lazar2222/PHI-GPC/README.md

# Human-Machine Interface for Music Applications

This graduation thesis project aimed to create a customizable control surface resembling audio mixers and video switchers. Implemented using an Arduino microcontroller and C# desktop software, the system enables full customization of each control. For detailed information, refer to the [thesis](Tex/maturski.pdf) and [presentation](Tex/Odbrana.pdf).
