lazar2222/PHI-GPC/Tex/Odbrana.pdf

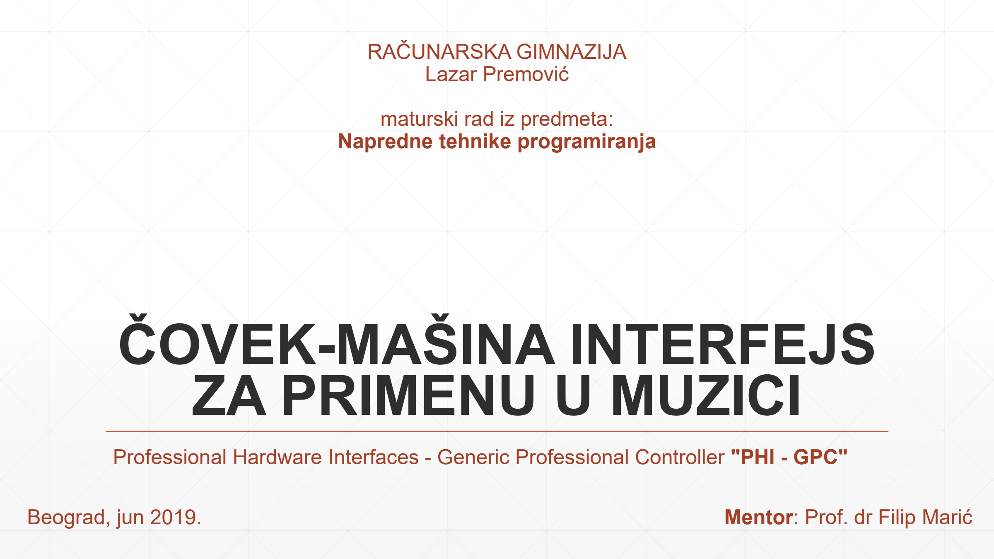
[picture p9: figure]
ČOVEK-MAŠINA INTERFEJS ZA PRIMENU U MUZICI; RAČUNARSKA GIMNAZIJA Lazar Premović; maturski rad iz predmeta: Napredne tehnike programiranja; Beograd, jun 2019.; Mentor: Prof. dr Filip Marić

Professional Hardware Interfaces - Generic Professional Controller "PHI - GPC"

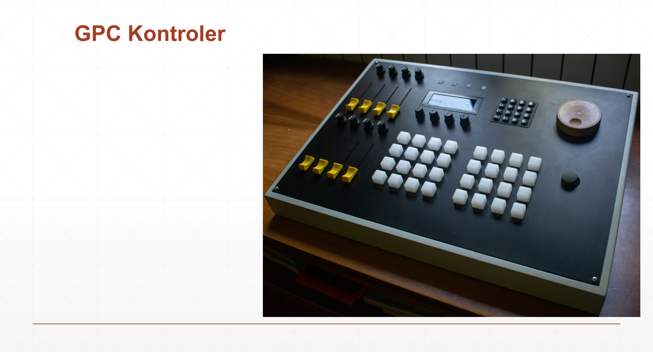
[picture p10: figure]
GPC Kontroler

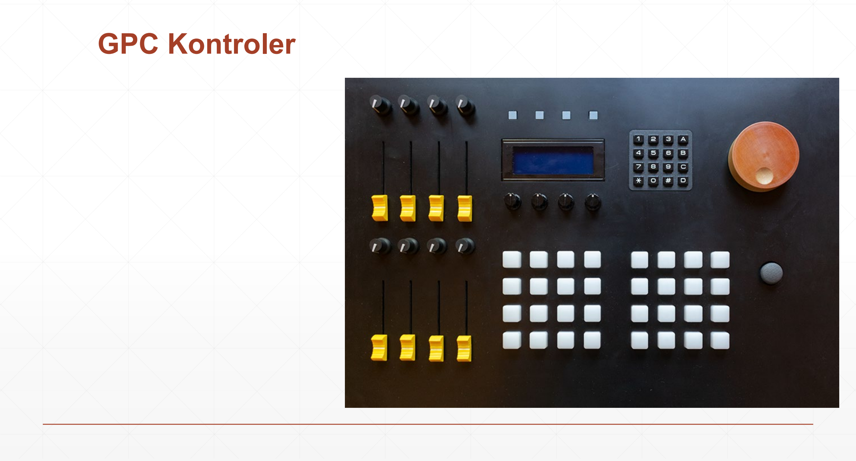
[picture p11: figure]
GPC Kontroler

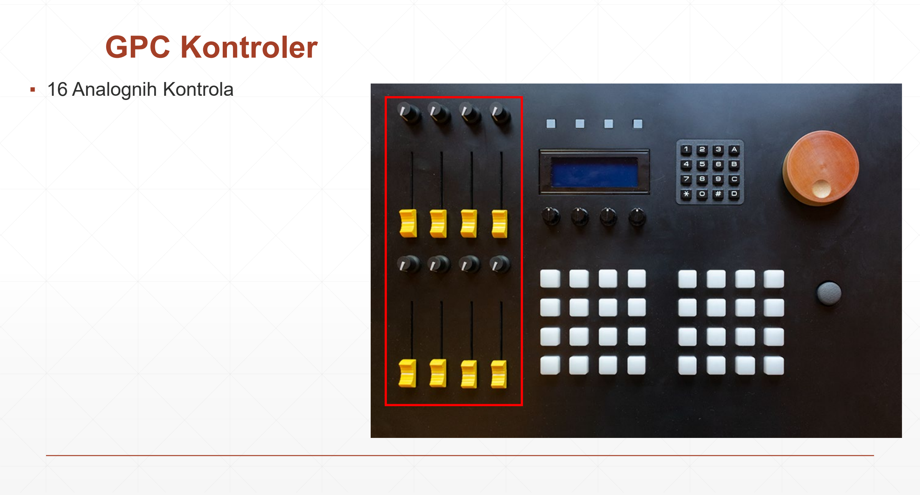
[picture p12: figure]
GPC Kontroler; ▪ 16 Analognih Kontrola

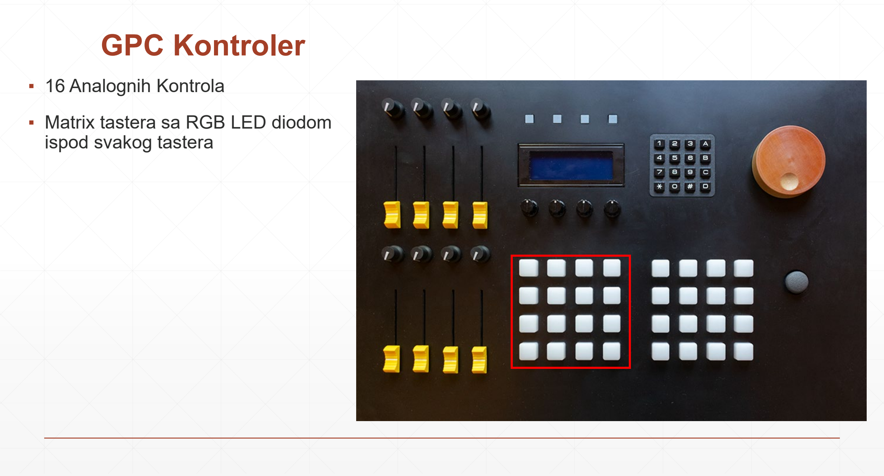
[picture p13: figure]
GPC Kontroler; ▪ 16 Analognih Kontrola ▪ Matrix tastera sa RGB LED diodom ispod svakog tastera

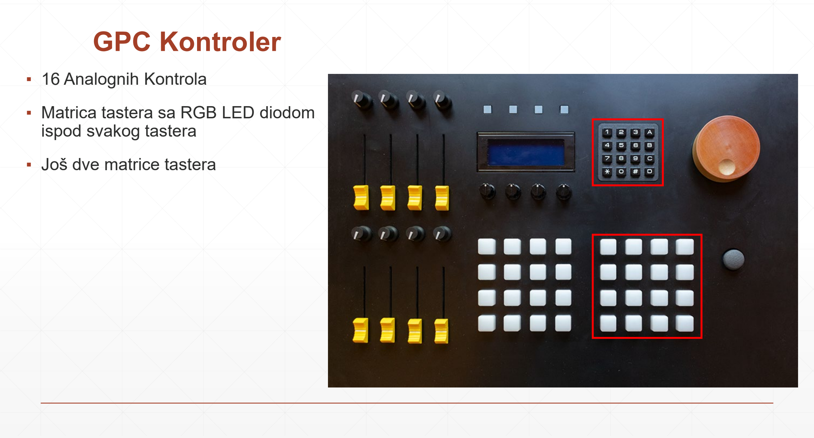
[picture p14: figure]
GPC Kontroler; ▪ 16 Analognih Kontrola ▪ Matrica tastera sa RGB LED diodom ispod svakog tastera ▪ Još dve matrice tastera

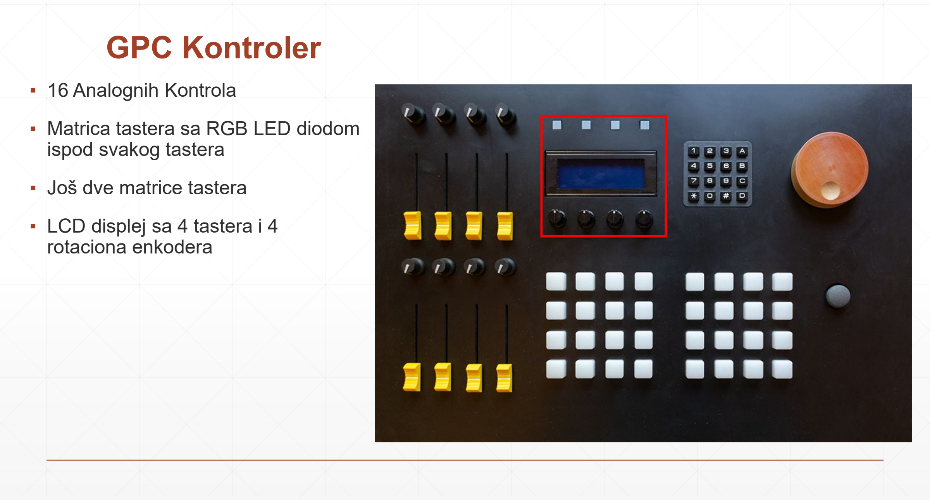
[picture p15: figure]
GPC Kontroler; ▪ 16 Analognih Kontrola ▪ Matrica tastera sa RGB LED diodom ispod svakog tastera ▪ Još dve matrice tastera ▪ LCD displej sa 4 tastera i 4 rotaciona enkodera

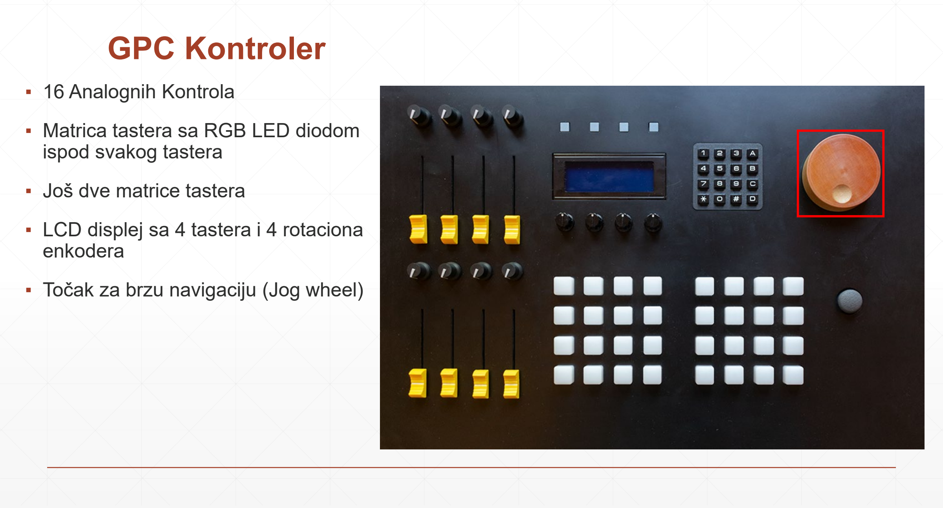
[picture p16: figure]
GPC Kontroler; ▪ 16 Analognih Kontrola ▪ Matrica tastera sa RGB LED diodom ispod svakog tastera ▪ Još dve matrice tastera; enkodera ▪ Točak za brzu navigaciju (Jog wheel)

- LCD displej sa 4 tastera i 4 rotaciona

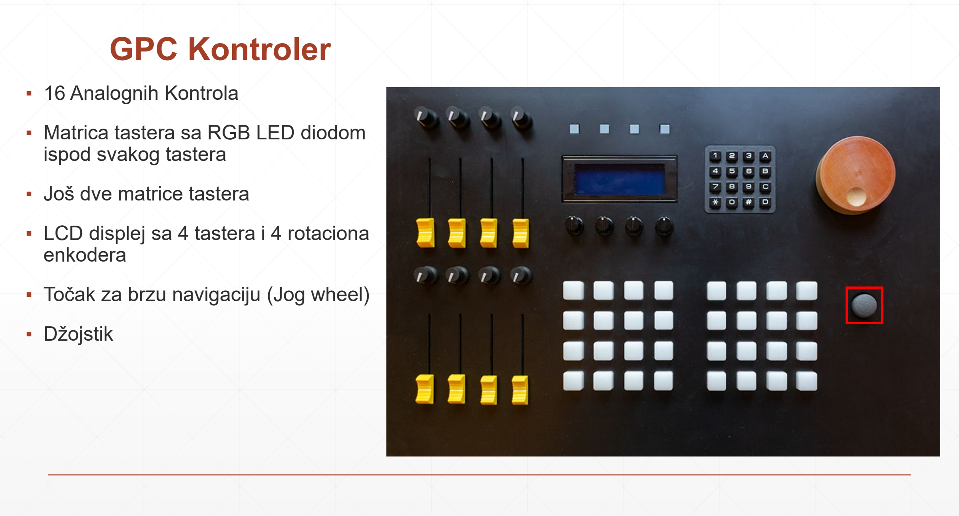
[picture p17: figure]
GPC Kontroler; ▪ 16 Analognih Kontrola ▪ Matrica tastera sa RGB LED diodom ispod svakog tastera ▪ Još dve matrice tastera; enkodera ▪ Točak za brzu navigaciju (Jog wheel) ▪ Džojstik

- LCD displej sa 4 tastera i 4 rotaciona

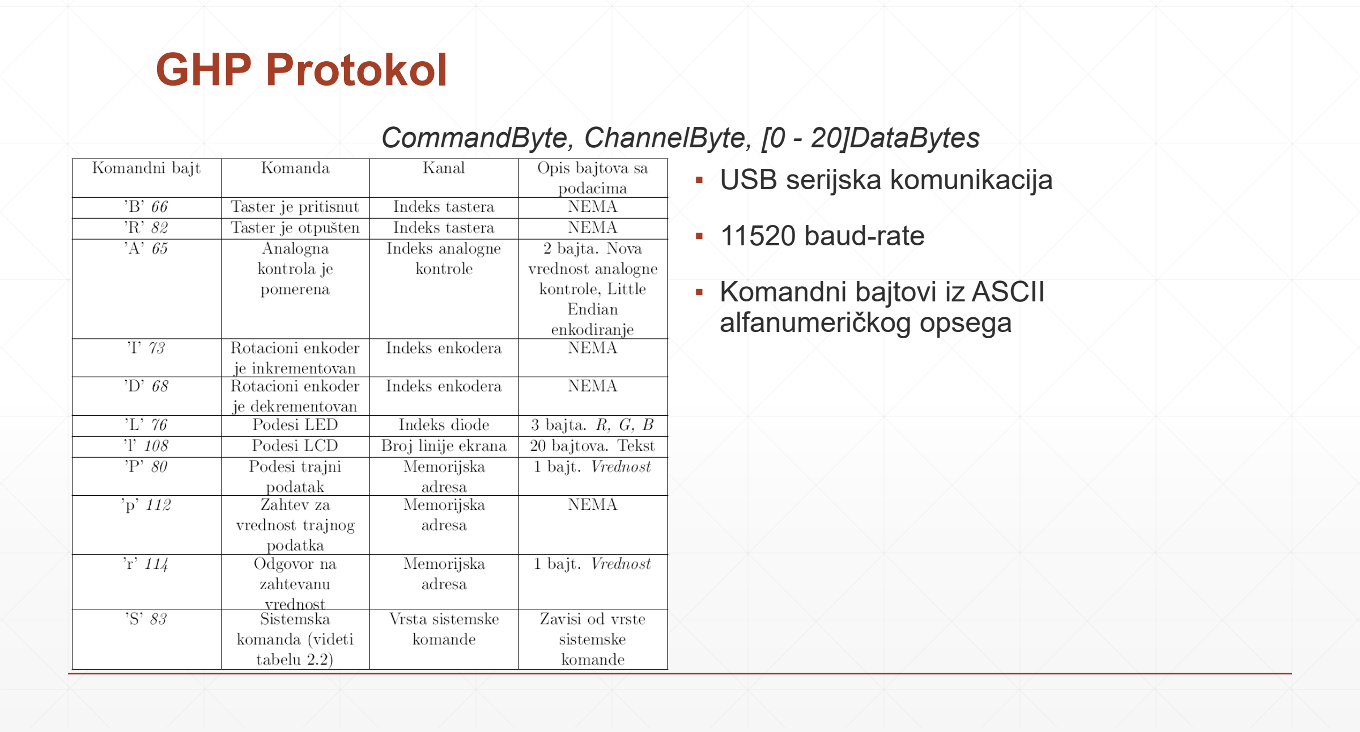
[picture p18: figure]
GHP Protokol; CommandByte, ChannelByte, [0 - 20]DataBytes ▪ USB serijska komunikacija ▪ 11520 baud-rate ▪ Komandni bajtovi iz ASCII alfanumeričkog opsega

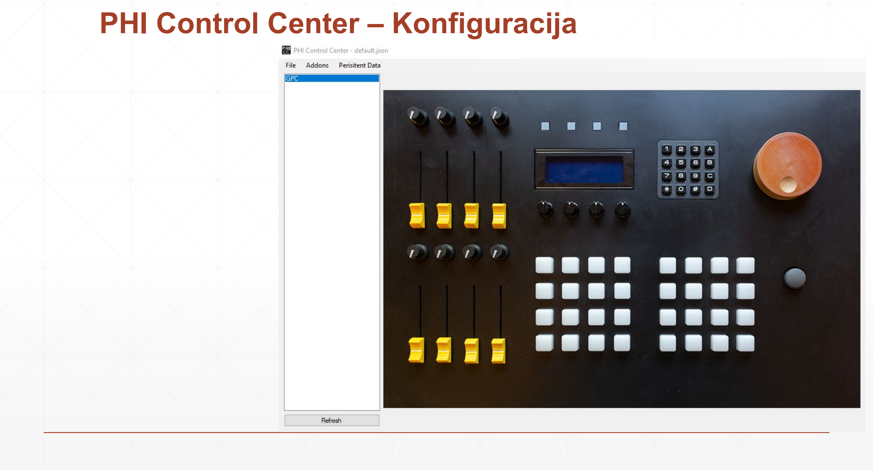
[picture p19: figure]
PHI Control Center – Konfiguracija

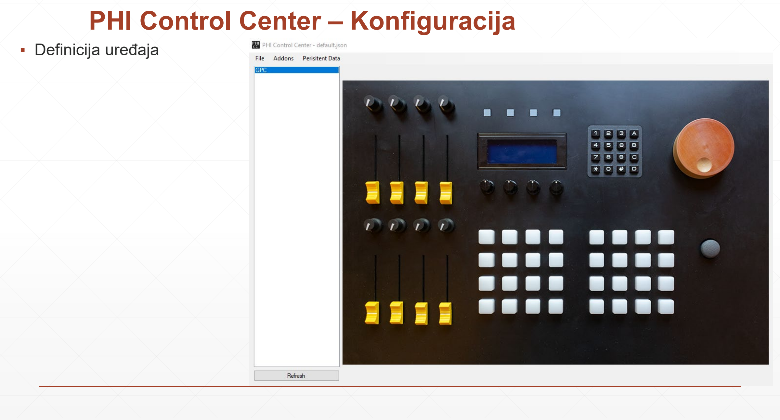
[picture p20: figure]
PHI Control Center – Konfiguracija; ▪ Definicija uređaja

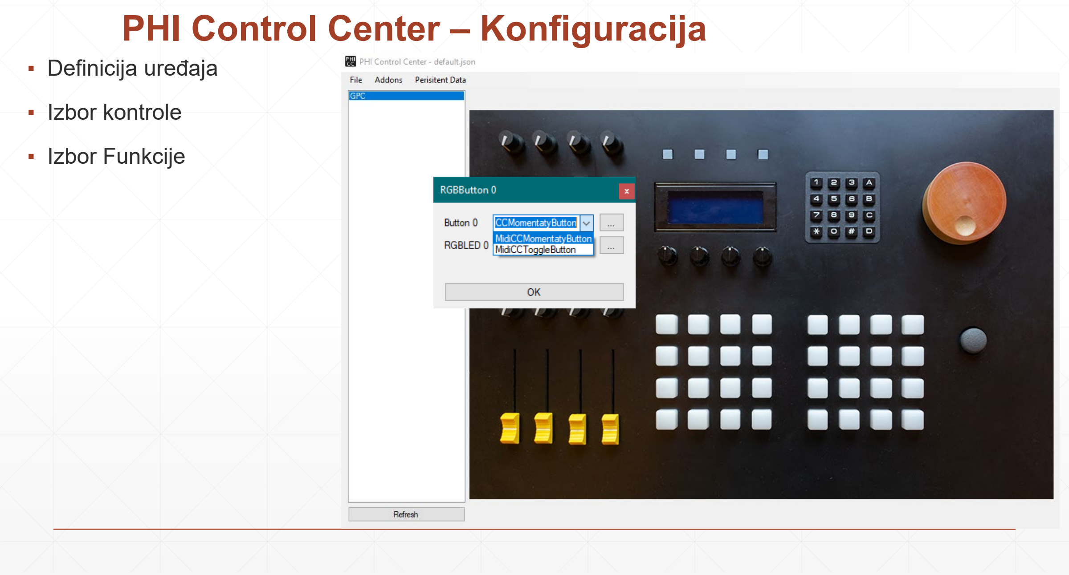
[picture p21: figure]
PHI Control Center – Konfiguracija; ▪ Definicija uređaja ▪ Izbor kontrole ▪ Izbor Funkcije

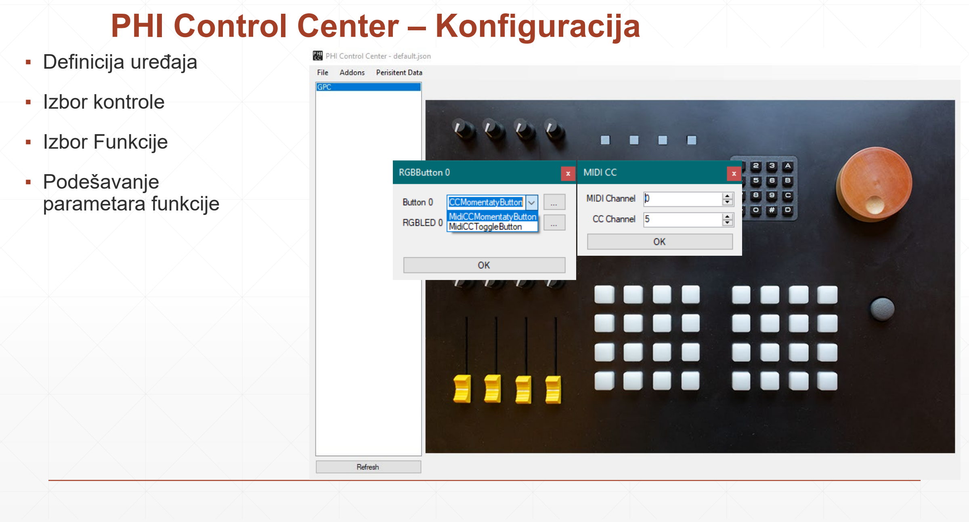
[picture p22: figure]
PHI Control Center – Konfiguracija; ▪ Definicija uređaja ▪ Izbor kontrole ▪ Izbor Funkcije ▪ Podešavanje parametara funkcije

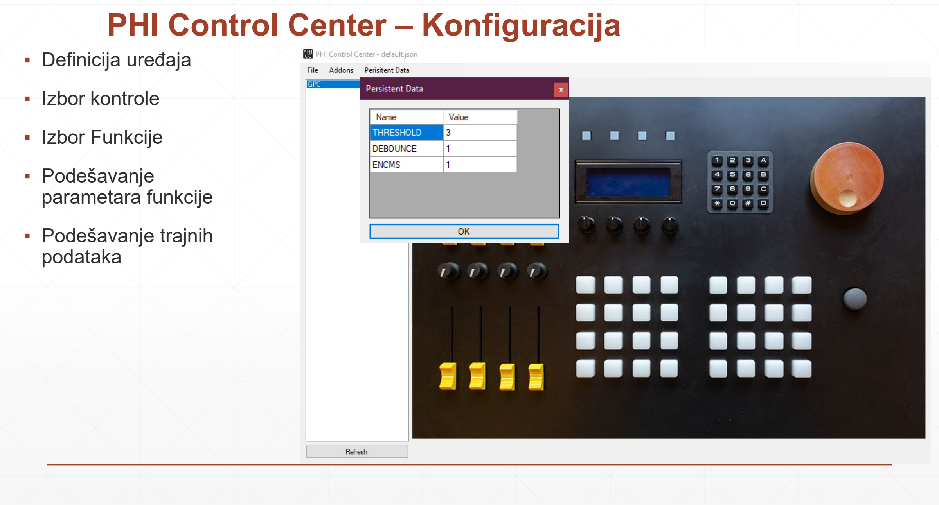
[picture p23: figure]
PHI Control Center – Konfiguracija; ▪ Definicija uređaja ▪ Izbor kontrole ▪ Izbor Funkcije ▪ Podešavanje parametara funkcije ▪ Podešavanje trajnih podataka

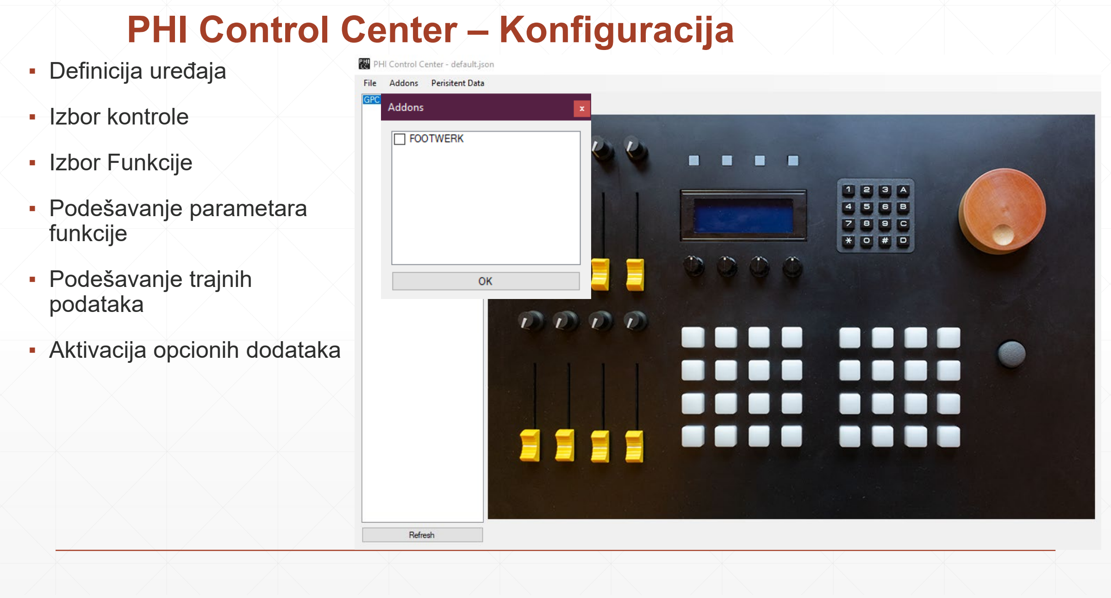
[picture p24: figure]
PHI Control Center – Konfiguracija; ▪ Definicija uređaja ▪ Izbor kontrole ▪ Izbor Funkcije ▪ Podešavanje parametara funkcije ▪ Podešavanje trajnih podataka ▪ Aktivacija opcionih dodataka

## PHI Control Center – Obrada u realnom vremenu

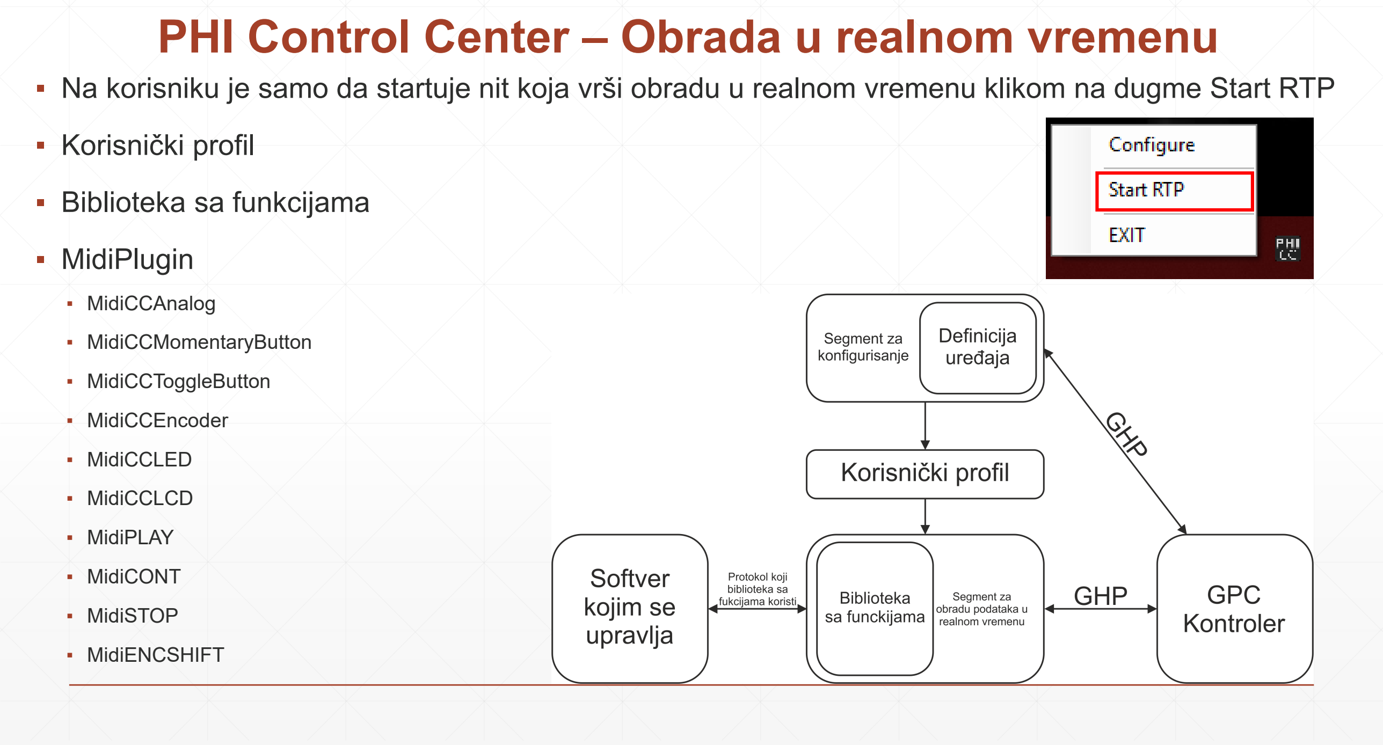
[picture p25: page 17]

- Na korisniku je samo da startuje nit koja vrši obradu u realnom vremenu klikom na dugme Start RTP
- Korisnički profil
- Biblioteka sa funkcijama
- MidiPlugin
- MidiCCAnalog
- MidiCCMomentaryButton
- MidiCCToggleButton
- MidiCCEncoder
- MidiCCLED
- MidiCCLCD
- MidiPLAY
- MidiCONT
- MidiSTOP
- MidiENCSHIFT

## DEMO

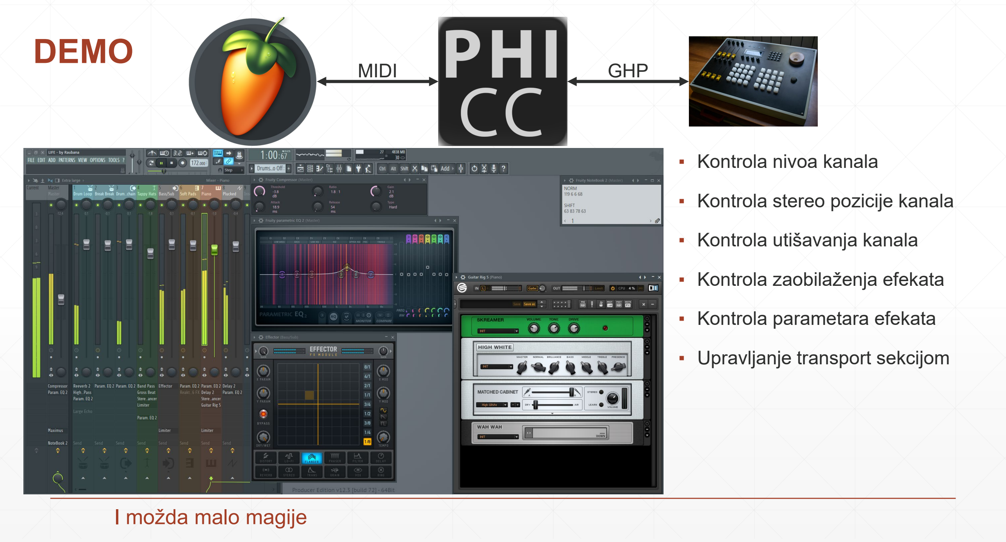
[picture p26: page 18]

- Kontrola nivoa kanala
- Kontrola stereo pozicije kanala
- Kontrola utišavanja kanala
- Kontrola zaobilaženja efekata
- Kontrola parametara efekata
- Upravljanje transport sekcijom

I možda malo magije

MIDI | GHP

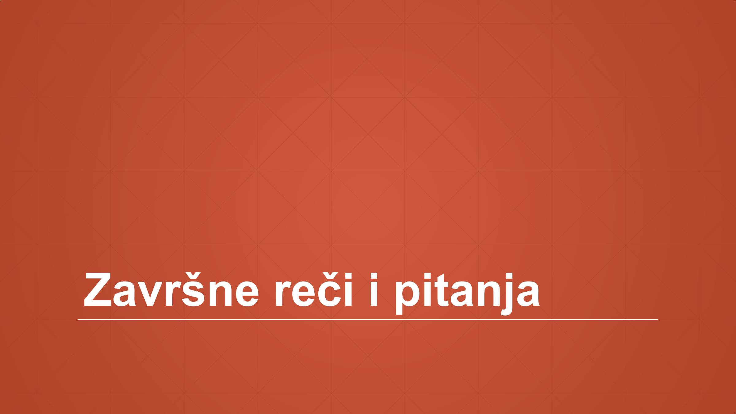
[picture p27: figure]
Završne reči i pitanja

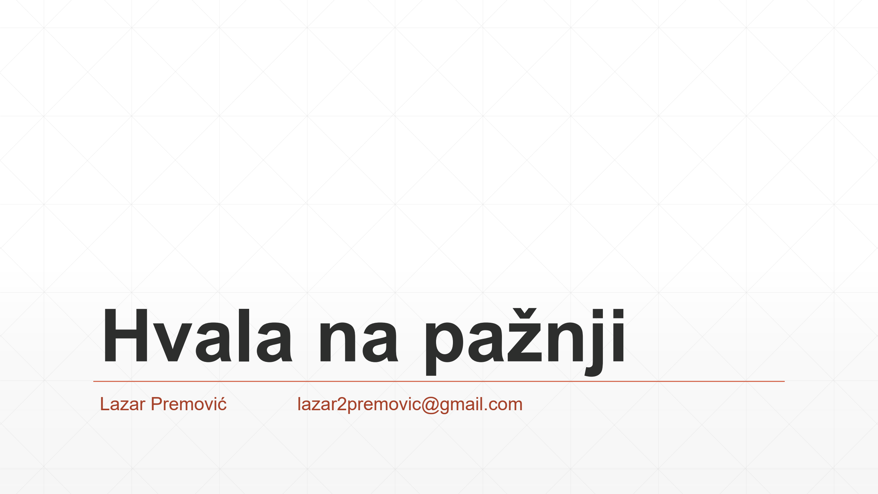
[picture p28: figure]
Hvala na pažnji; Lazar Premović; lazar2premovic@gmail.com
