lazar2222/PHI-GPC/Tex/maturski.pdf

RAČUNARSKA GIMNAZIJA

Lazar Premović

IZRADA ČOVEK-MAŠINA INTERFEJSA ZA

PRIMENU U MUZICI

Professional Hardware Interfaces - Generic Professional Controller "PHI - GPC"

maturski rad iz predmeta:

Napredne tehnike programiranja

Mentor:

Prof. dr Filip Marić

Beograd, maj 2019.

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
