lazar2222/PHI-GPC/Tex/images/fls.png

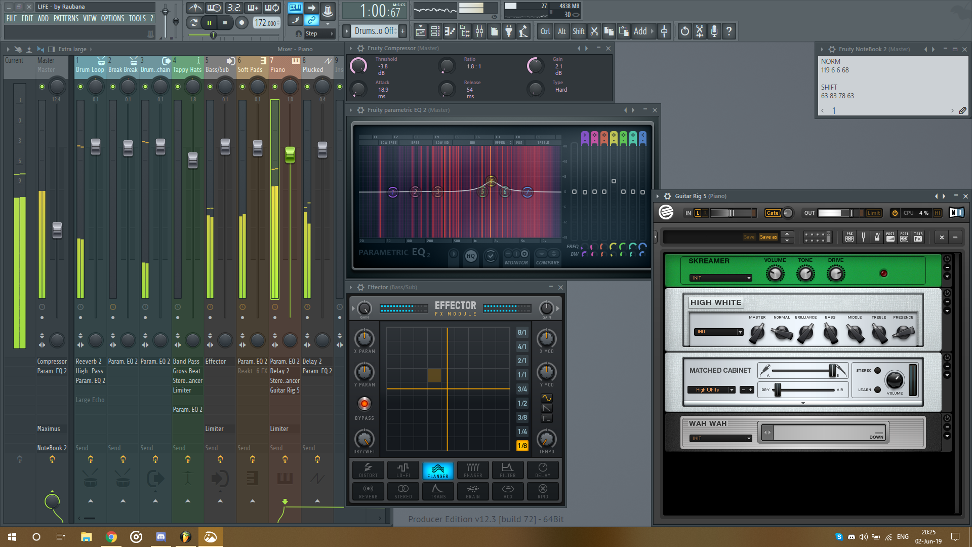
Tex/images/fls.png
