lazar2222/PHI-GPC/Tex/images/GPCp.pdf

5V

## MatrixBus

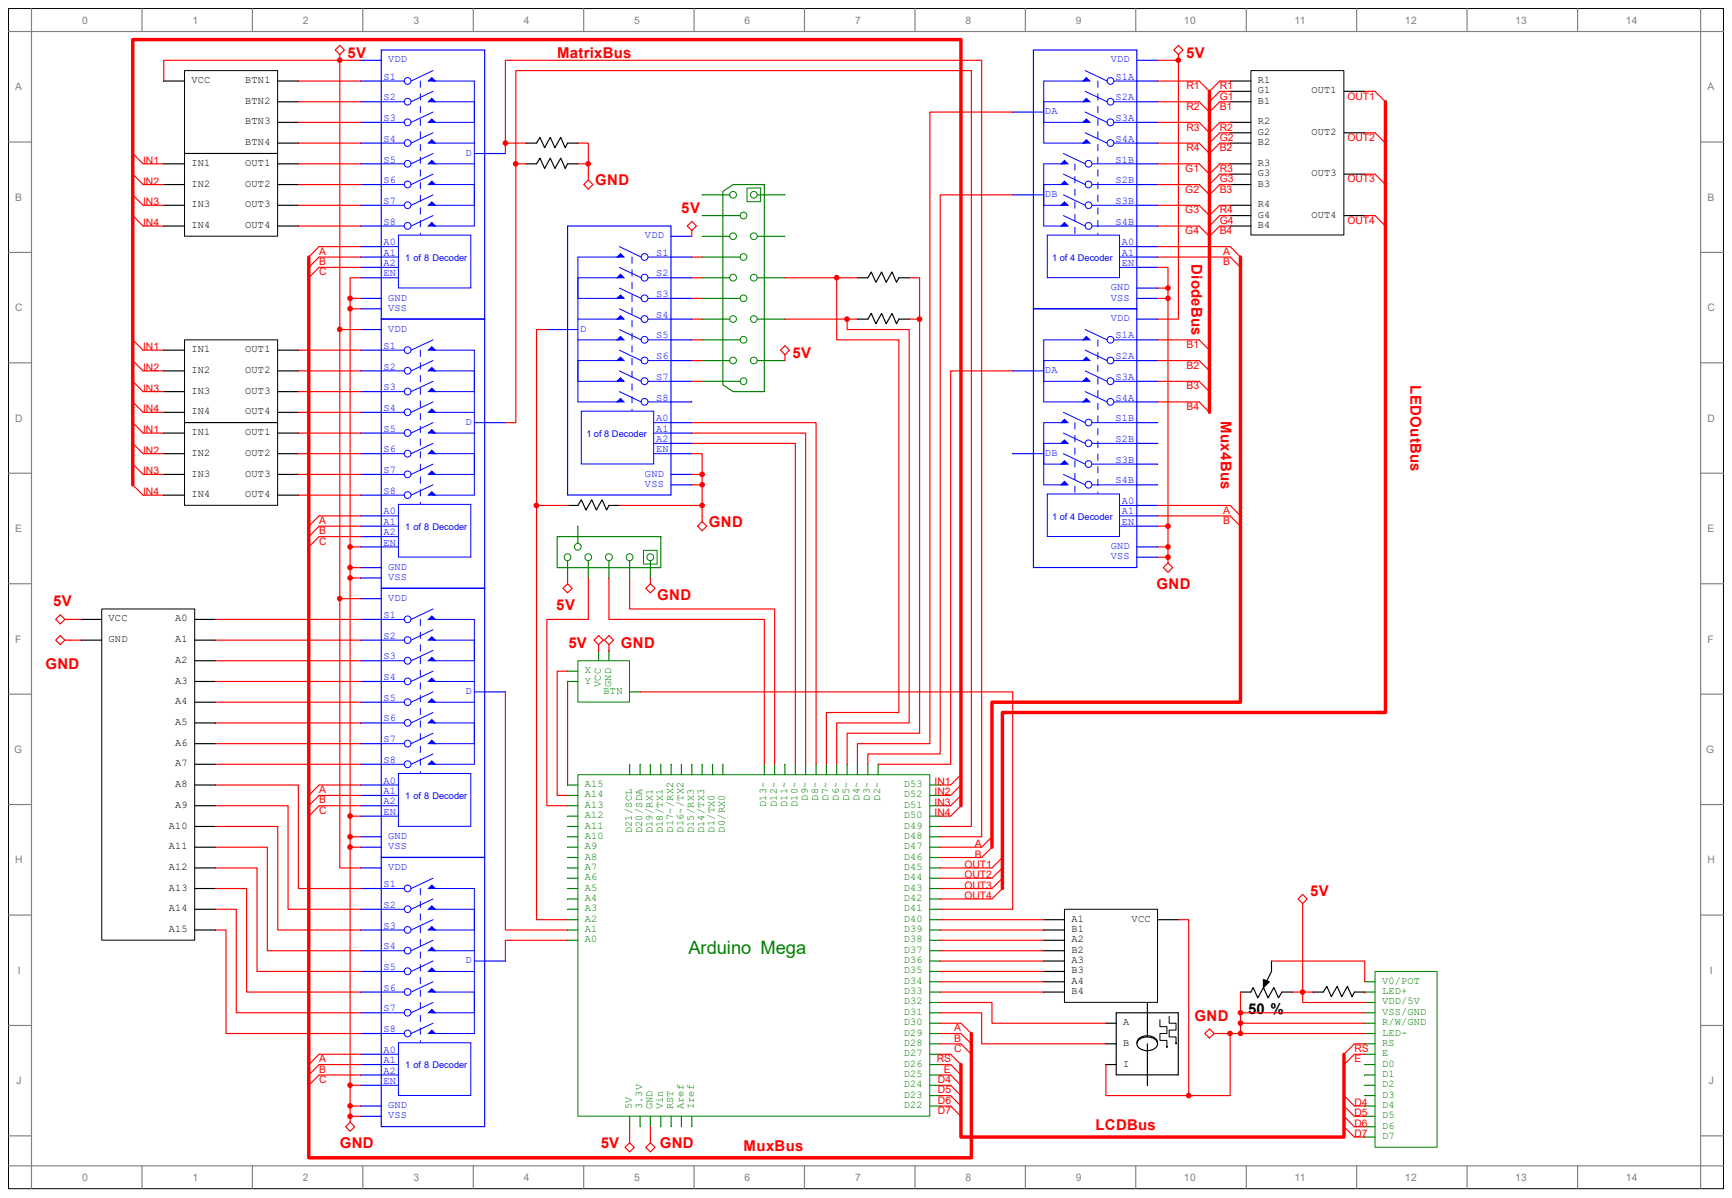
[picture p31: page 1]

A | A
B | B

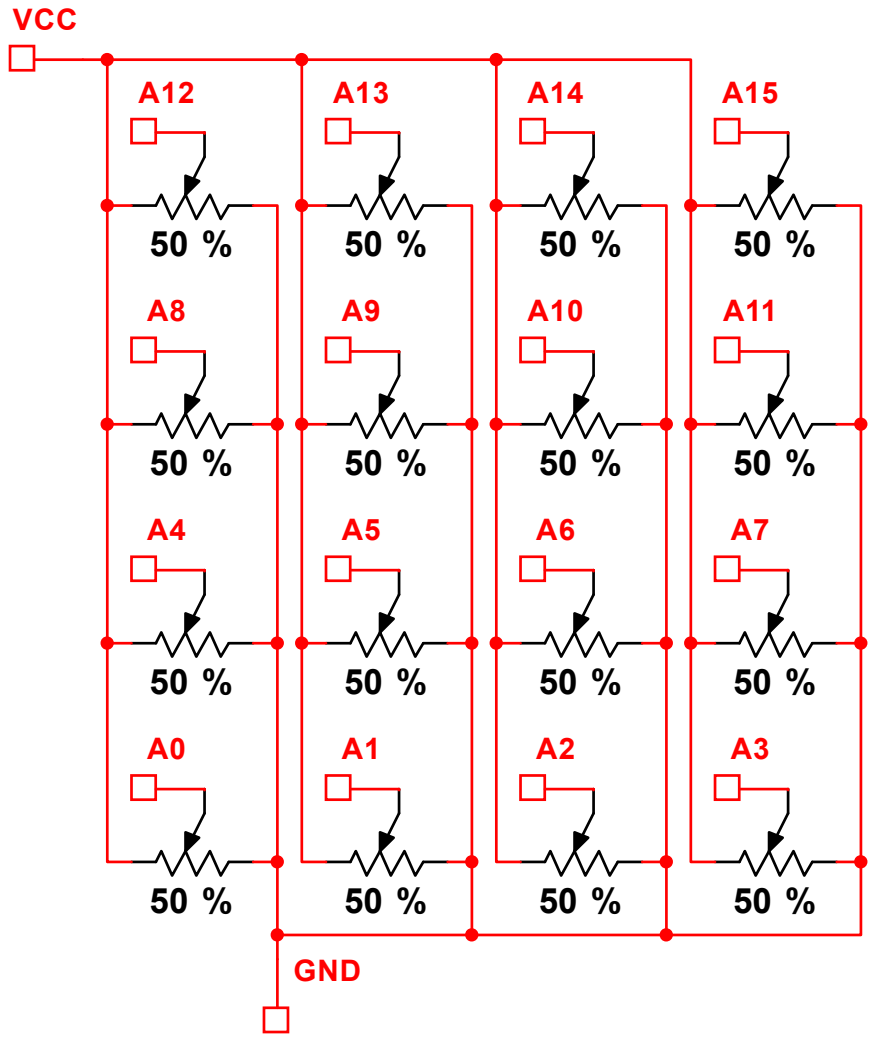
[picture p32: page 2]
VCC; GND

A | A
B | B

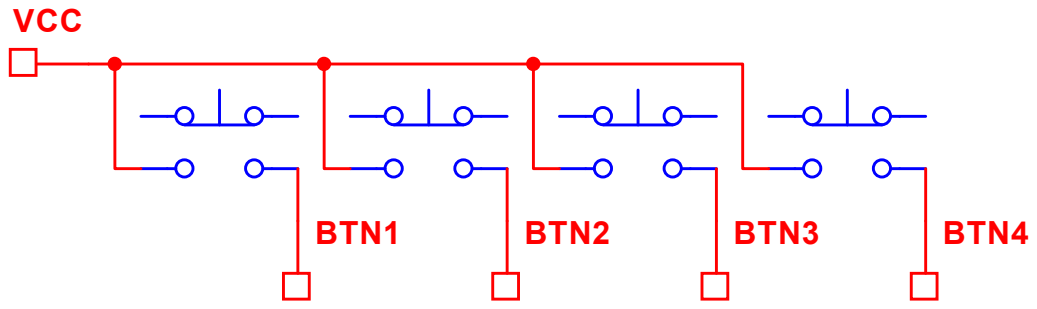
[picture p33: page 3]
VCC; BTN1; BTN2; BTN3; BTN4

A | A
B | B

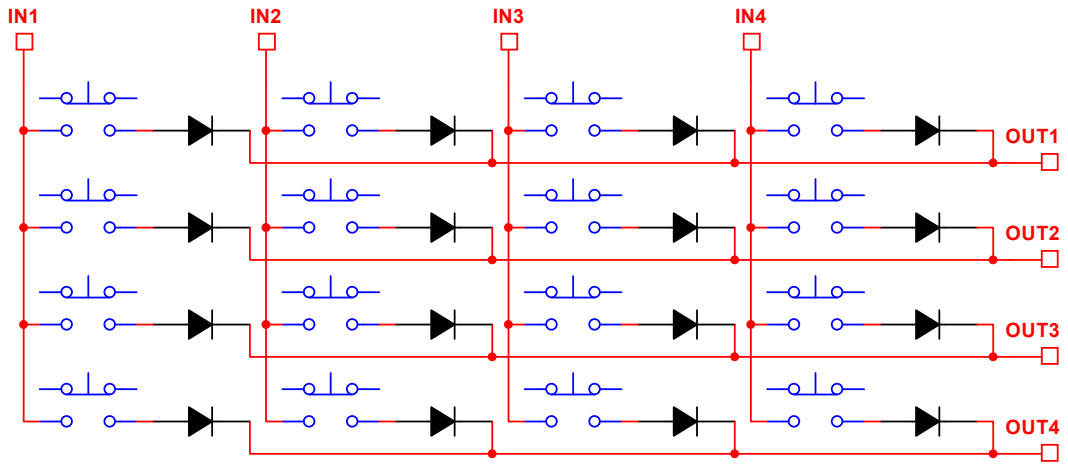
[picture p34: page 4]
OUT1; OUT2; OUT3; OUT4

A | A
B | B

A | A
B | B

A | A
B | B

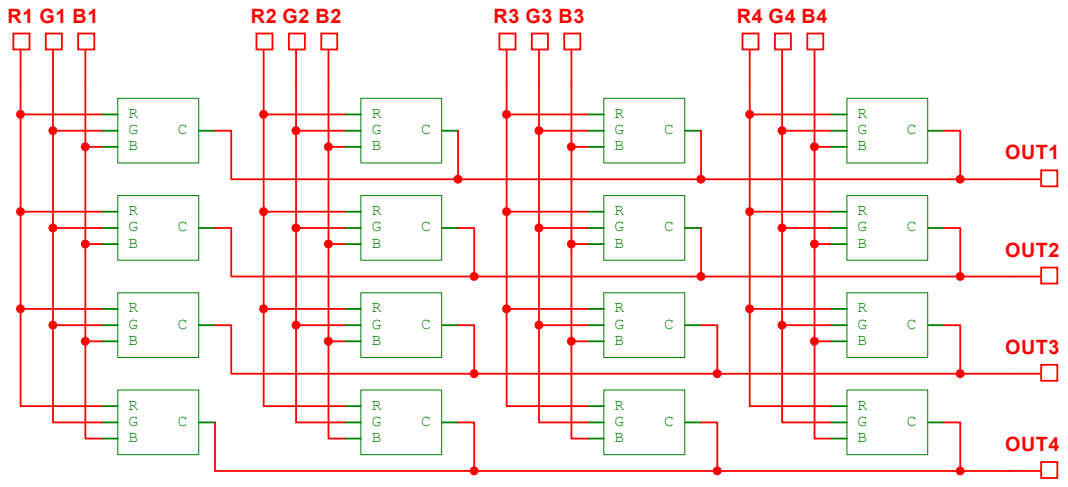
[picture p35: page 7]
OUT1; OUT2; OUT3; OUT4

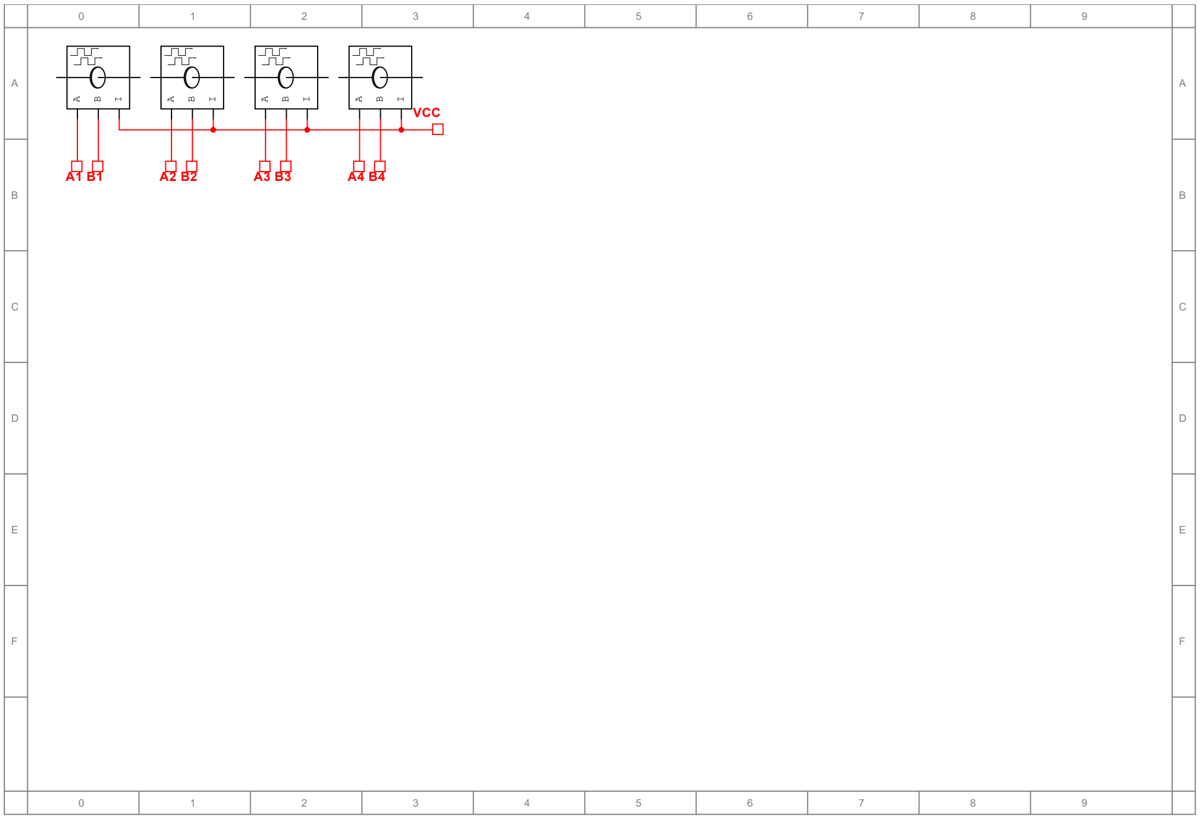
[picture p36: figure]
ABIABIABIABI; VCC
