lazar2222/PHI-GPC/Tex/images/GPCPhysical.pdf

5V

## MatrixBus

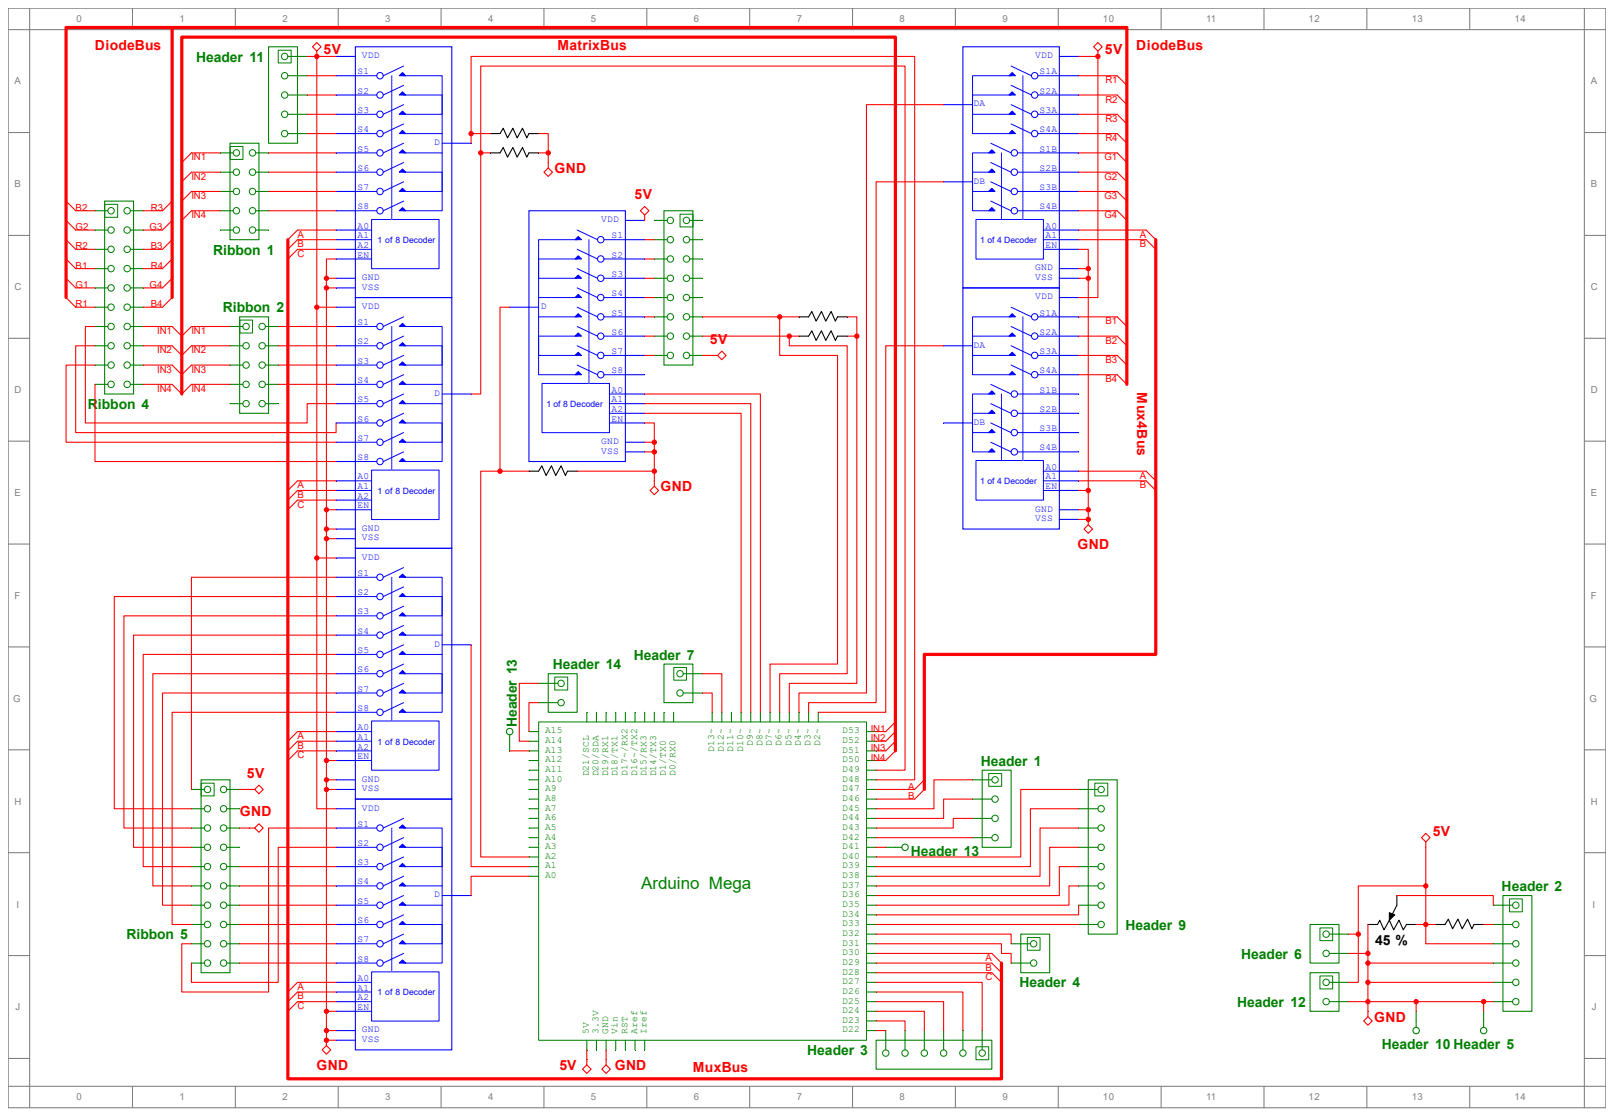
[picture p37: page 1]

## Header 10 To Board

## Header 9 To arduino

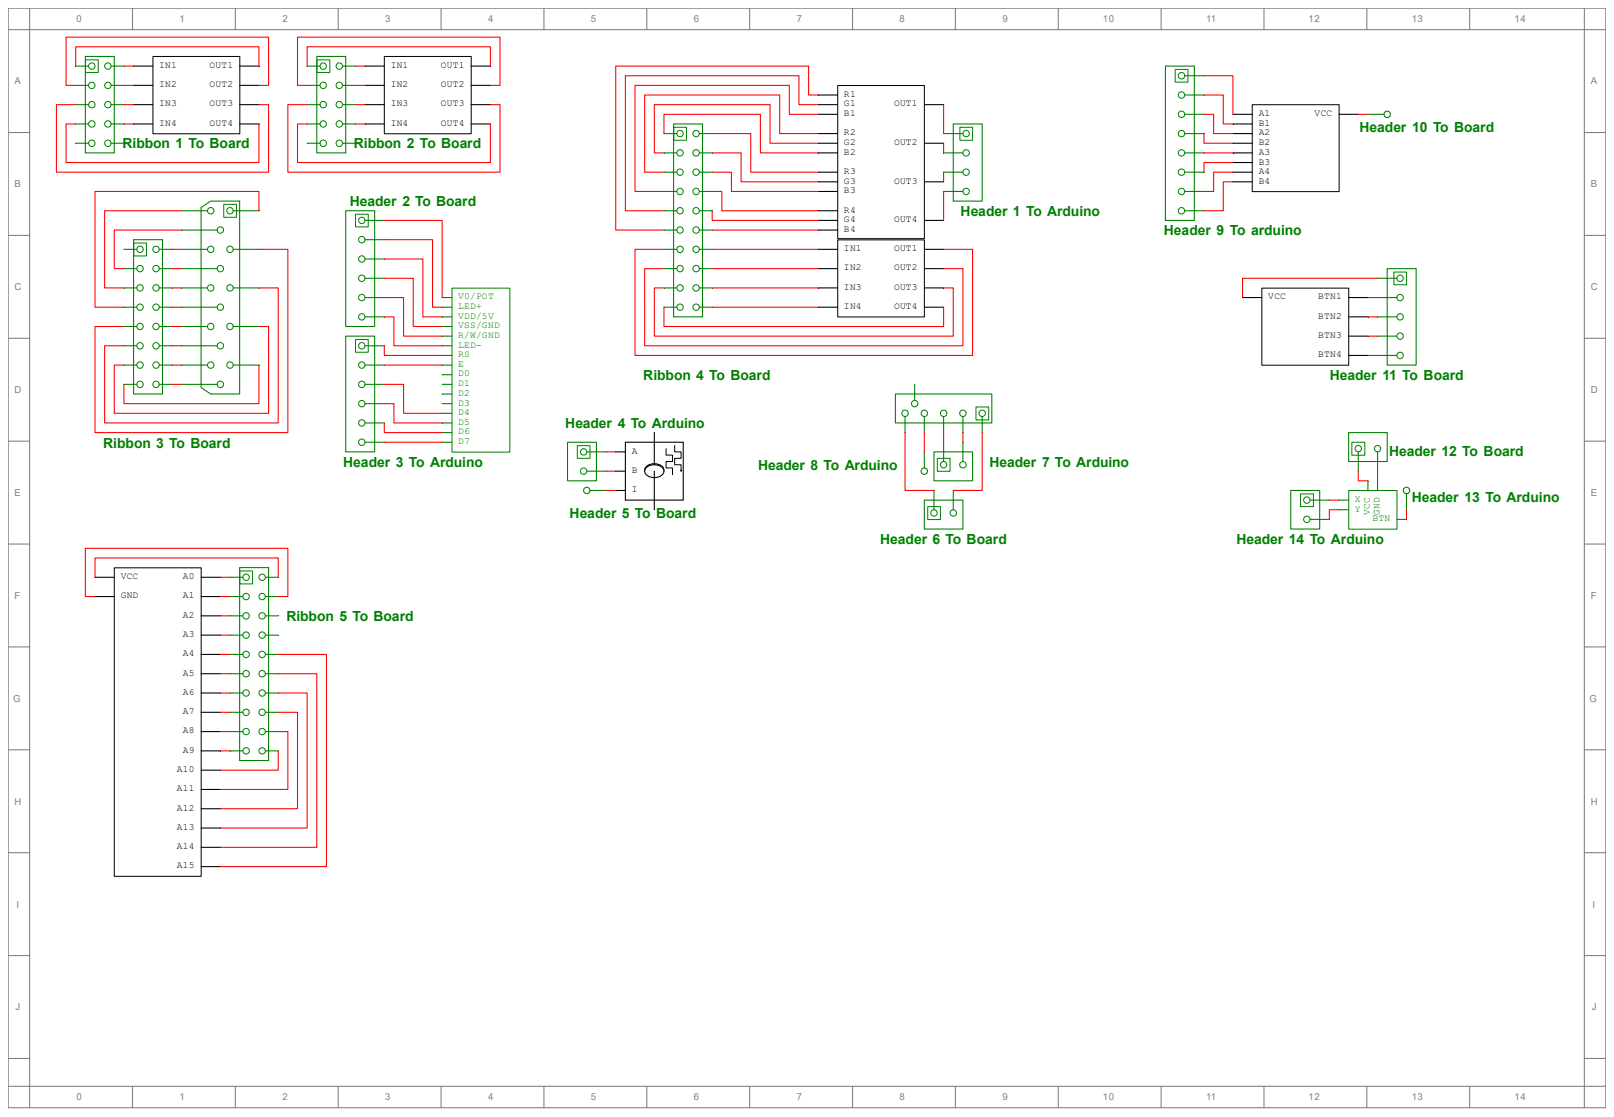
[picture p38: page 2]

# A15 5V3.3V GND Vin RST Aref Iref

## Header 14

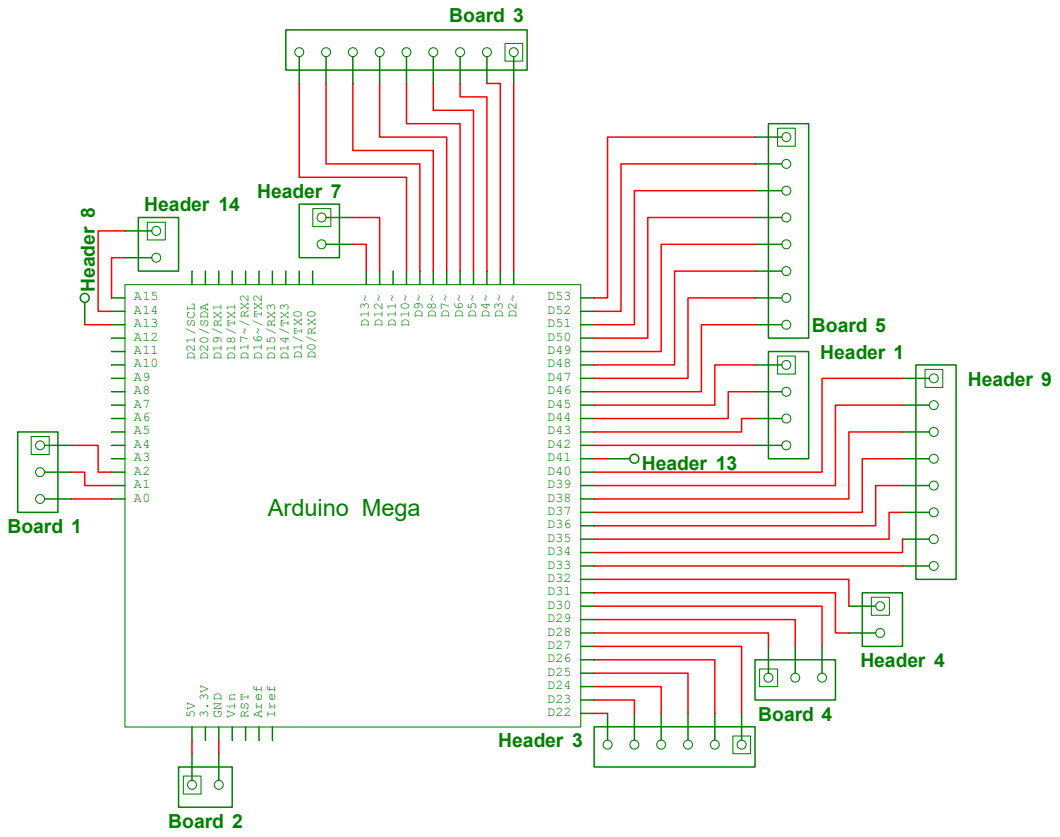
[picture p39: page 3]

5V_1 | 5V_1

5V_1

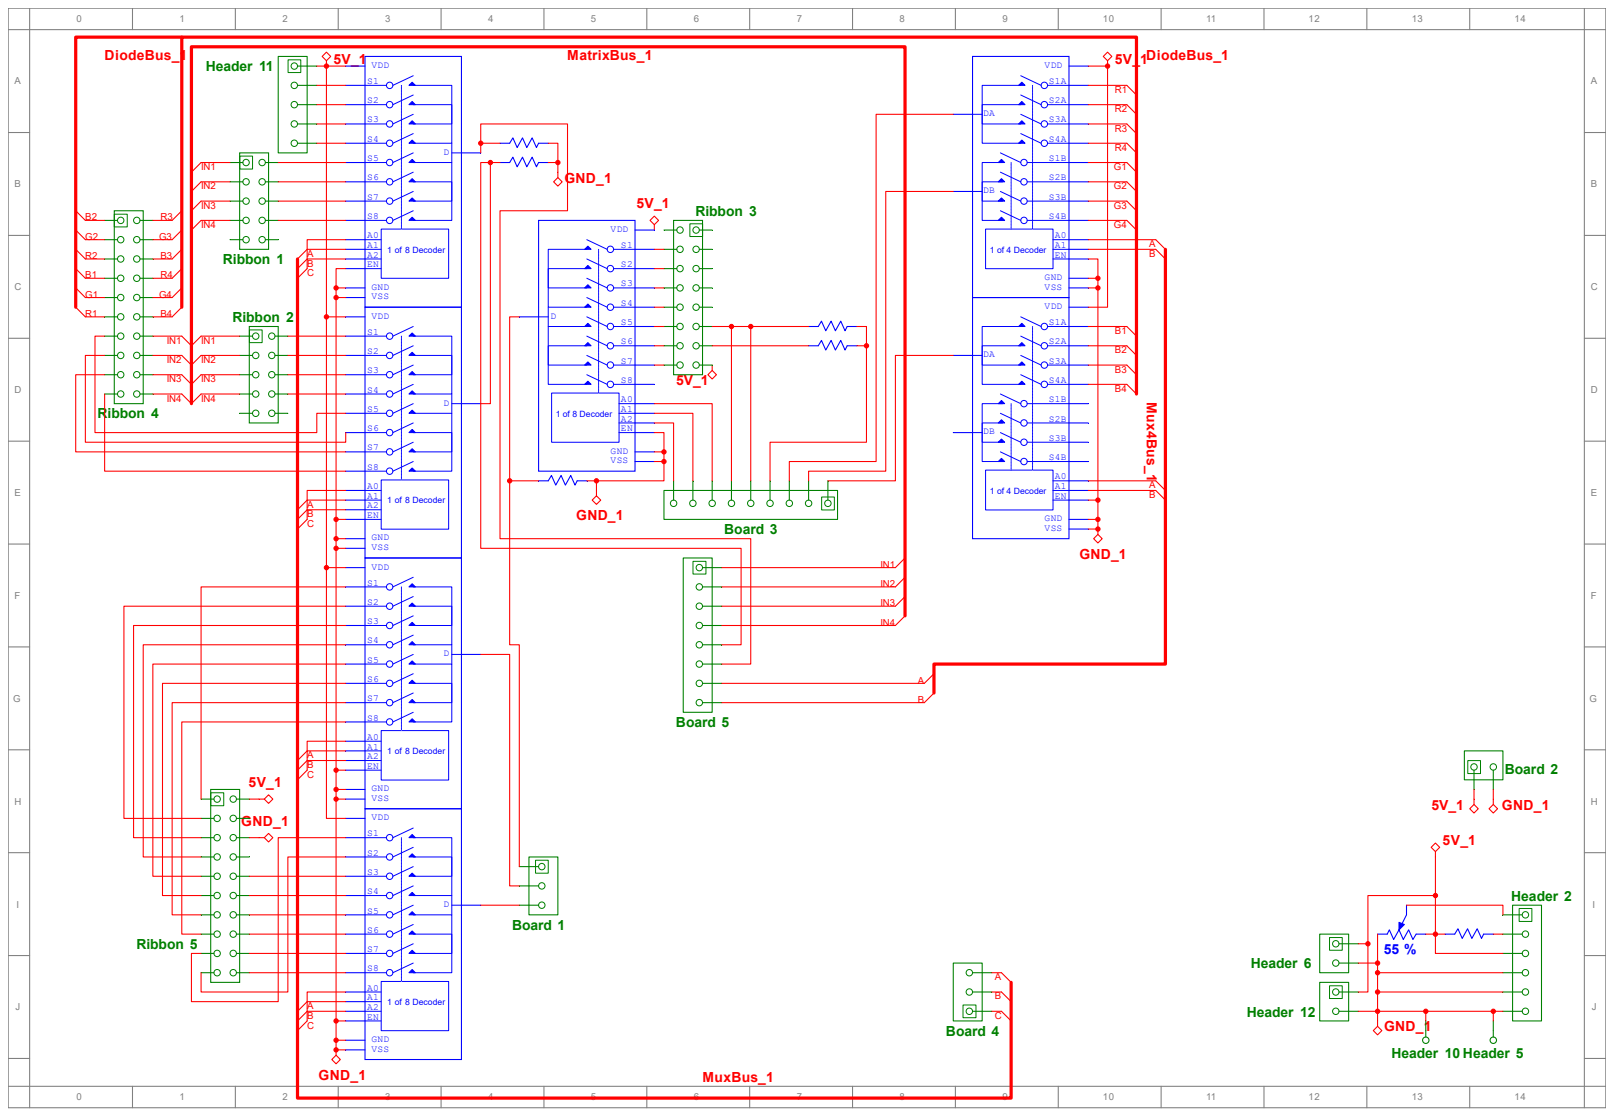
[picture p40: page 4]
1 of 8 Decoder; VDD; GND VSS; 1 of 4 Decoder; GND_1; MuxBus_1; ABCABC; ABCCBA; MatrixBus_1; CBA; ABMux4Bus_1 AB; Ribbon 5; Header 2; Header 12; Header 11; Ribbon 1; Ribbon 2; Ribbon 4; DiodeBus_1; Header 10 Header 5; Header 6; Ribbon 3; Board 2; Board 3; Board 1; Board 4; Board 5

A A

B B

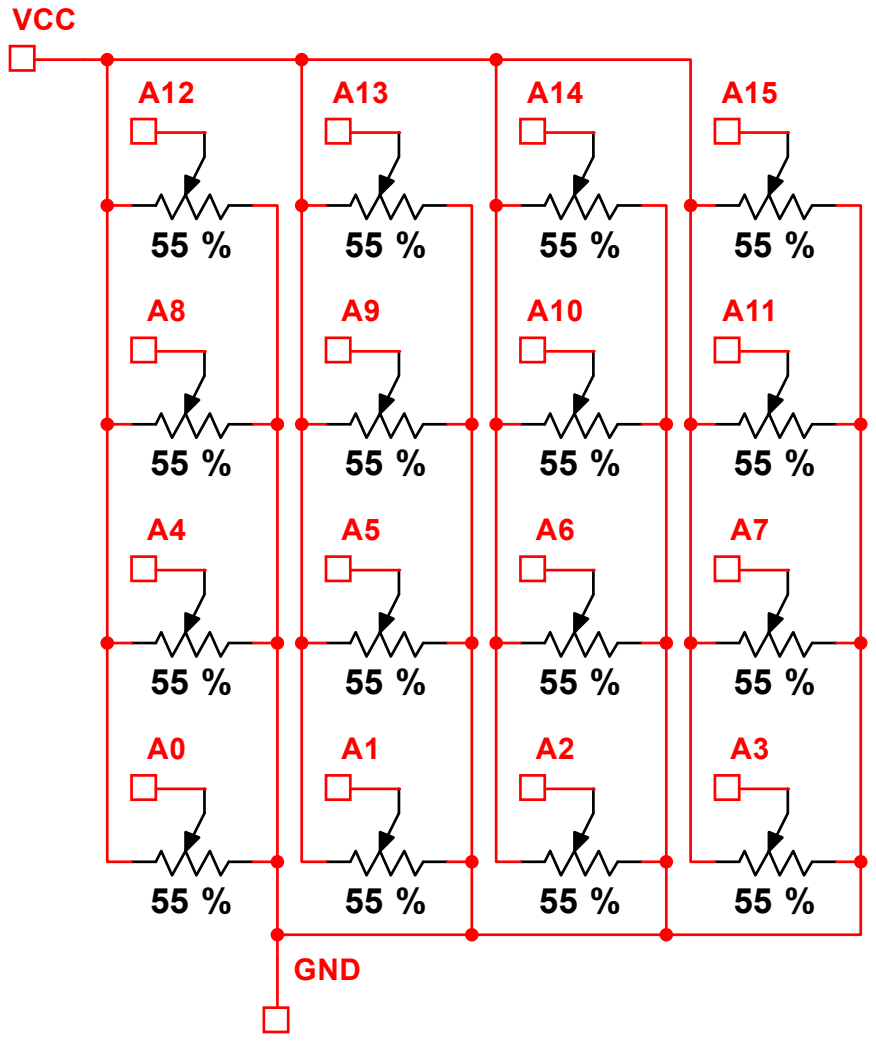
[picture p41: page 5]
VCC; GND

A A

B B

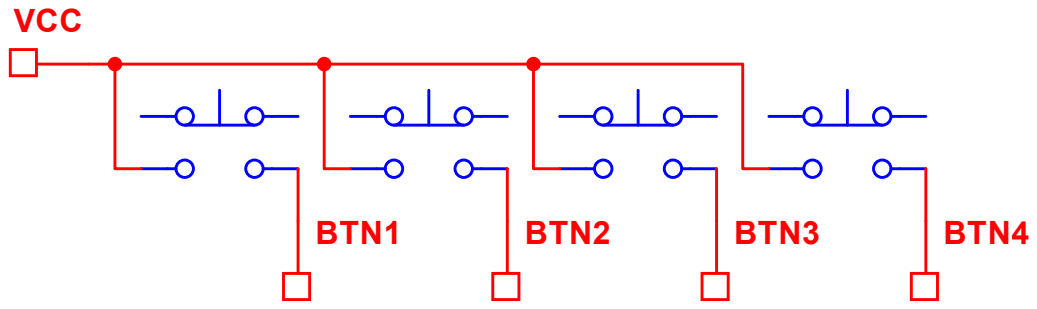
[picture p42: page 6]
VCC; BTN1; BTN2; BTN3; BTN4

A A

B B

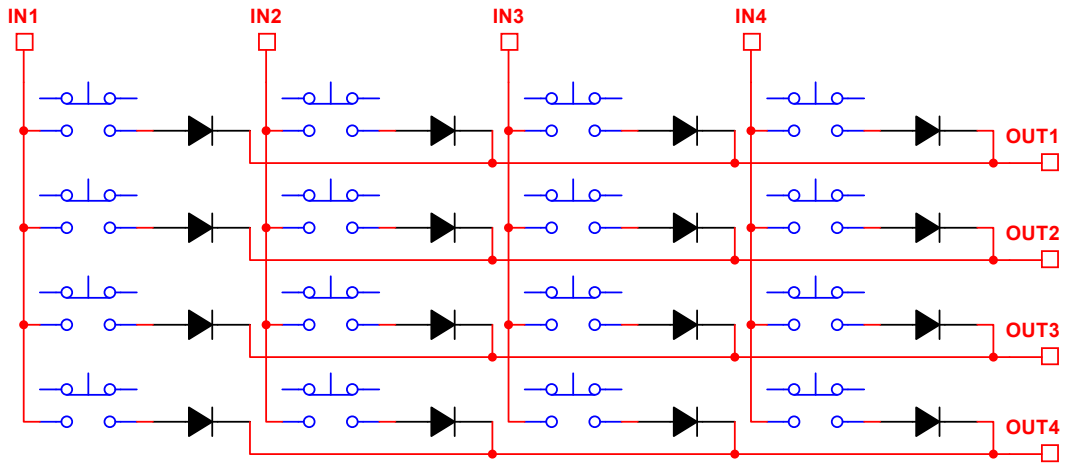
[picture p43: page 7]
OUT1; OUT2; OUT3; OUT4

A A

B B

A A

B B

A A

B B

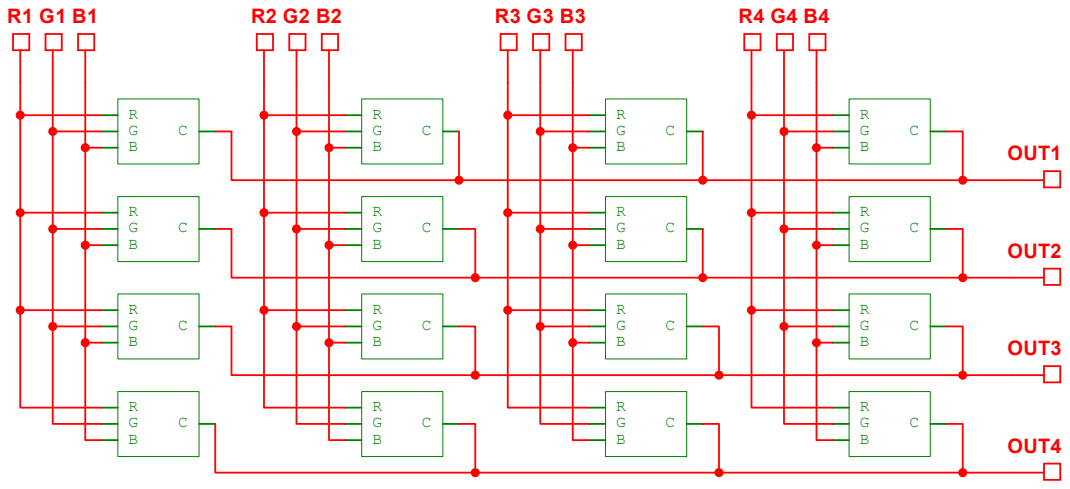
[picture p44: page 10]
OUT1; OUT2; OUT3; OUT4

A A

B B

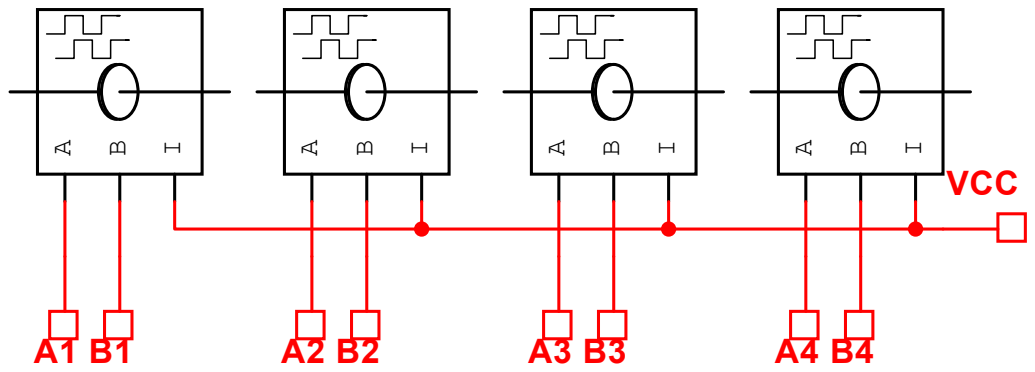
[picture p45: page 11]
VCC
