lazar2222/PHI-GPC/Tex/images/Board.pdf

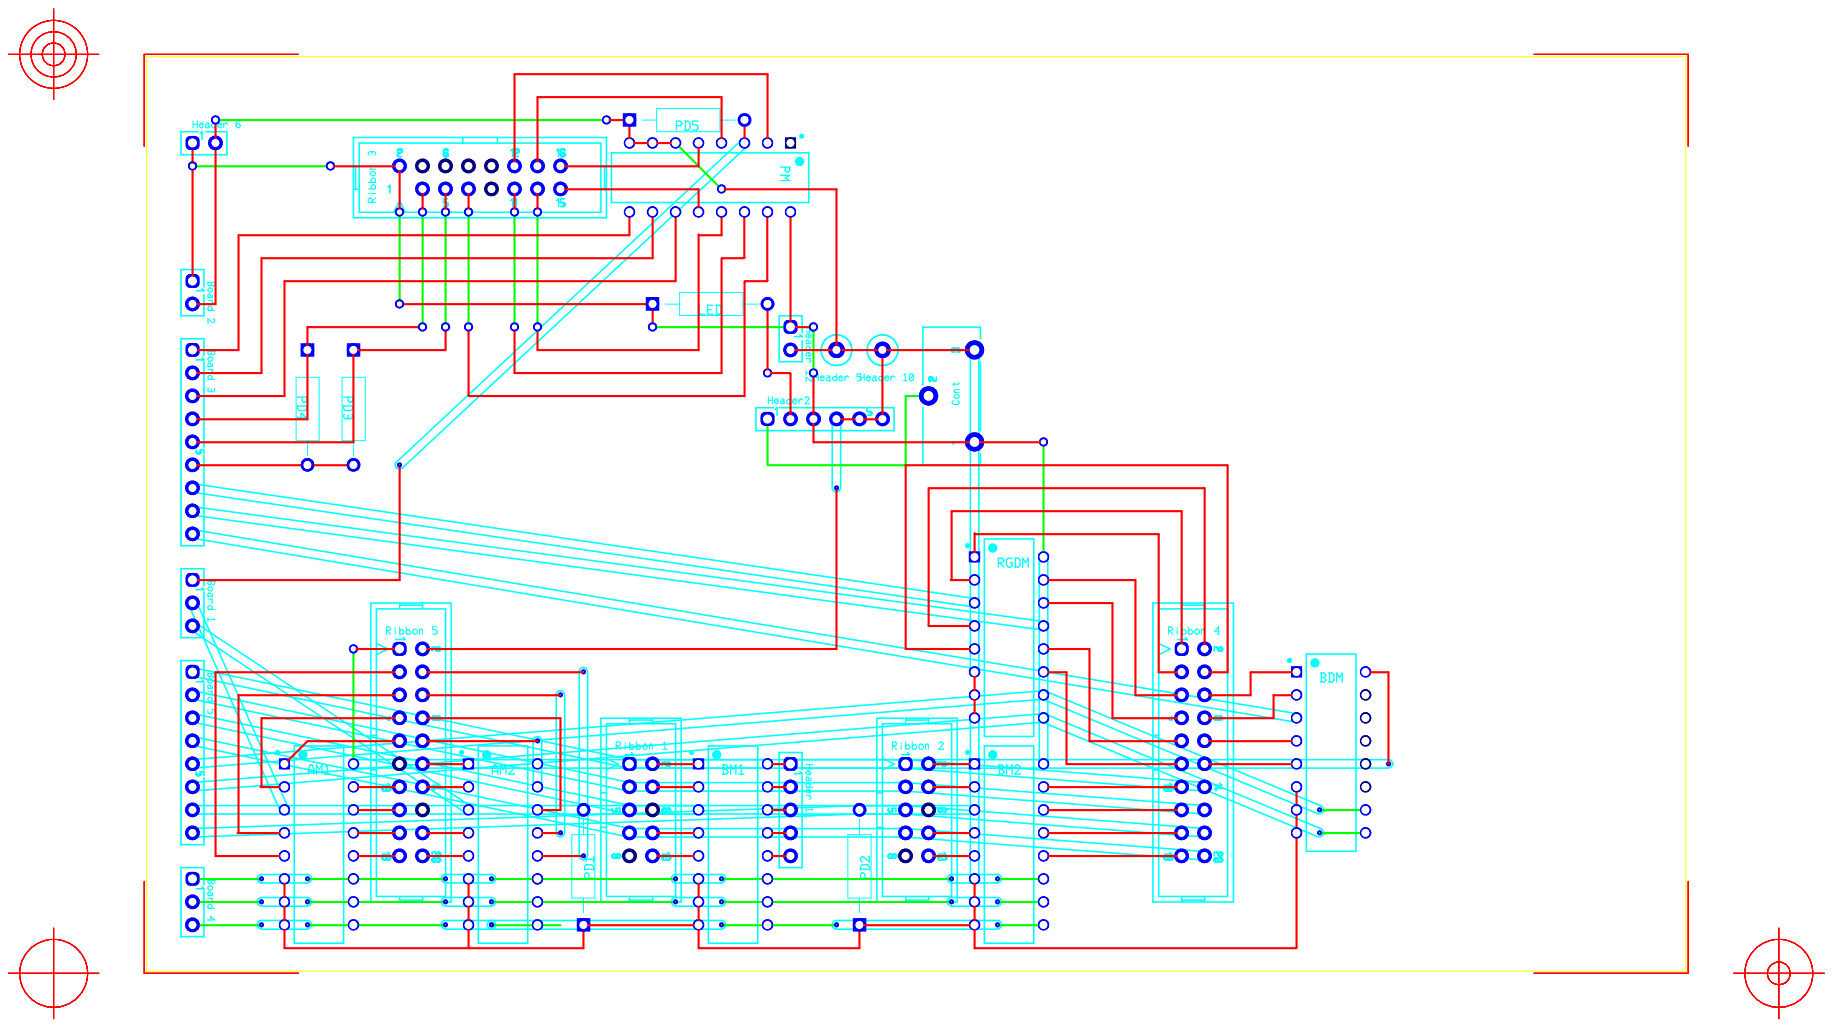
[picture p46: page 1]
