lazar2222/PHI-GPC/(list of files, drawings)

Other design files:
Multisim/EXPress.ms14
Multisim/FootWerk.ms14
Multisim/GPC.ms14
Multisim/GPCPhysical.ms14
Multisim/RESponce.ms14
